Tsumgo/Solar-Landscape-Lights-Control-System/PolarLightSys/学习资料/引脚约束.png

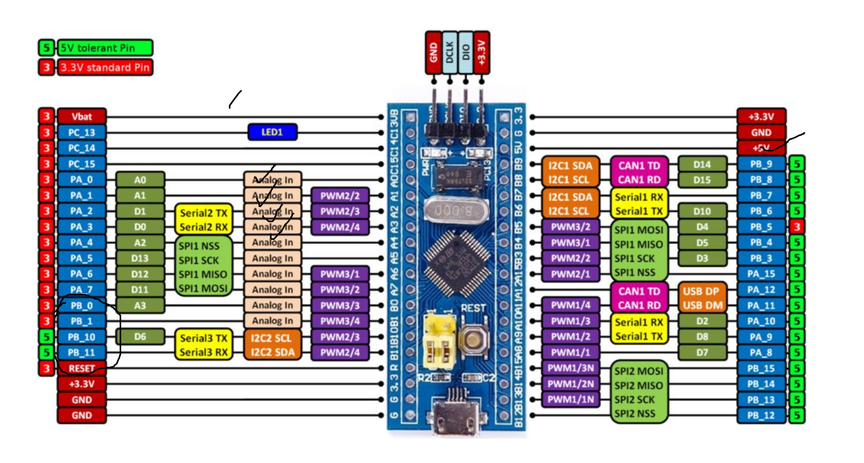
PolarLightSys/学习资料/引脚约束.png
