Tsumgo/Solar-Landscape-Lights-Control-System/PolarLightSys/学习资料/blueTooth/Bluetooth UART Board/c2_jtag2.jpg

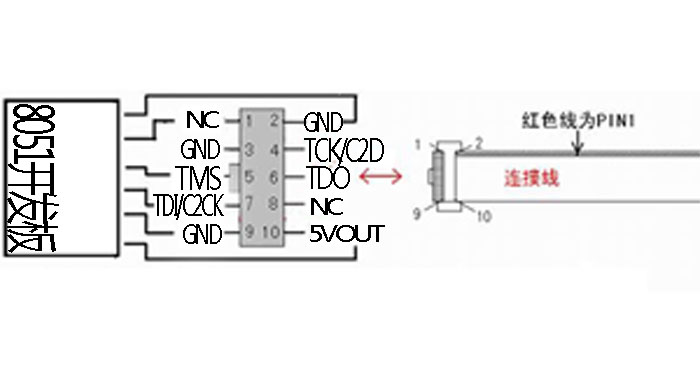
PolarLightSys/学习资料/blueTooth/Bluetooth UART Board/c2_jtag2.jpg
