Tsumgo/Solar-Landscape-Lights-Control-System/PolarLightSys/PCB/G07-太阳能景观灯-BOM.xlsx

No. | Quantity | Comment | Designator | Footprint | Value | Manufacturer Part | Manufacturer | Supplier Part | Supplier
1 | 3 | KF2EDGK-5.08-2P | BAT,LED,SOL | CONN-TH_2P-P5.08_DB2EVC-5.08-2P-BK |  | KF2EDGK-5.08-2P |  | C9900089420 | LCSC
2 | 4 | 10uF | C1,C8,C9,C10 | CAP-TH_BD12.5-P5.00-D0.6-FD | 10uF | EWH2WM220W20OT | AISHI(艾华集团) |  | LCSC
3 | 1 | 22uF | C2 | CAP-TH_BD12.5-P5.00-D0.6-FD | 22uF | EWH2WM220W20OT | AISHI(艾华集团) | C160173 | LCSC
4 | 2 | 470pF | C3,C4 | CAP-TH_L5.3-W3.2-P2.54-D0.6-S2.65 | 470pF | CC1H104ZA1ED3F5O1100 | Dersonic(德尔创) |  | LCSC
5 | 9 | 0.1uF | C5,C6,C7,C11,C12,C13,C14,C15,C16 | CAP-TH_L5.3-W3.2-P2.54-D0.6-S2.65 | 0.1uF | CC1H104ZA1ED3F5O1100 | Dersonic(德尔创) |  | LCSC
6 | 1 | M7 | D1 | SMA_L4.3-W2.6-LS5.2-RD |  | M7 | MDD(辰达半导体) | C95872 | LCSC
7 | 1 | AMS1117-5.0 | LVR | SOT-223_L6.5-W3.5-P2.30-LS7.0-BR |  | AMS1117-5.0 | AMS | C6187 | LCSC
8 | 2 | STP75NF75 | Q1,Q2 | TO-220-3_L10.0-W4.5-P2.54-L |  | STP75NF75 | ST(意法半导体) | C13678 | LCSC
9 | 21 | AXIAL-0.4 | R2,R3,R4,R6,R7,R8,R9,R10,R11,R14,R15,R16,R17,R18,R19,R20,R21,R22,R23,R24,R25 | RES-TH_BD2.7-L8.8-P12.80-D0.5 |  | AXIAL-0.4 |  | C9900024059 | LCSC
10 | 2 | 100mΩ | R5,R13 | R2512 | 100mΩ | CSRN2512FKR500 | SEI(Stackpole Electronics Inc.) |  | LCSC
11 | 1 | 4Ω | R12 | R2512 | 4Ω | CSRN2512FKR500 | SEI(Stackpole Electronics Inc.) |  | LCSC
12 | 2 | 10kΩ | R26,R27 | R2512 | 10kΩ | CSRN2512FKR500 | SEI(Stackpole Electronics Inc.) |  | LCSC
13 | 1 | STM32103C8T6 | STM1 | STM32_C8T6_核心板
14 | 4 | TS665CJ | SW1,SW2,SW3,SW4 | SW-TH_4P-L6.0-W6.0-P4.50-LS6.5 |  | TS665CJ | SHOU HAN(首韩) | C393938 | LCSC
15 | 2 | XH2.54_20P | U2,U3 | XH2.54_20P
16 | 1 | LM358FVT-GE2 | U4 | TSSOP-8_L4.4-W3.0-P0.65-LS6.4-BL |  | LM358FVT-GE2 | ROHM(罗姆) | C4369934 | LCSC
17 | 1 | HS96L03W2C03 | U6 | OLED-TH_L27.8-W27.2-P2.54_C9900033791 |  | HS96L03W2C03 | HS(汉昇) | C5248080 | LCSC
18 | 1 | ICL7660M/TR | U7 | SOP-8_L4.9-W3.9-P1.27-LS6.0-BL |  | ICL7660M/TR | HGSEMI(华冠) | C356724 | LCSC
19 | 2 | 8050 | U8,U9 | TO-92-3_L4.8-W3.7-P2.54-R |  | 8050 | BLUE ROCKET(蓝箭) | C3037602 | LCSC
