Tsumgo/Solar-Landscape-Lights-Control-System/PolarLightSys/学习资料/NANO STM32F1_V2.0_SCH.pdf

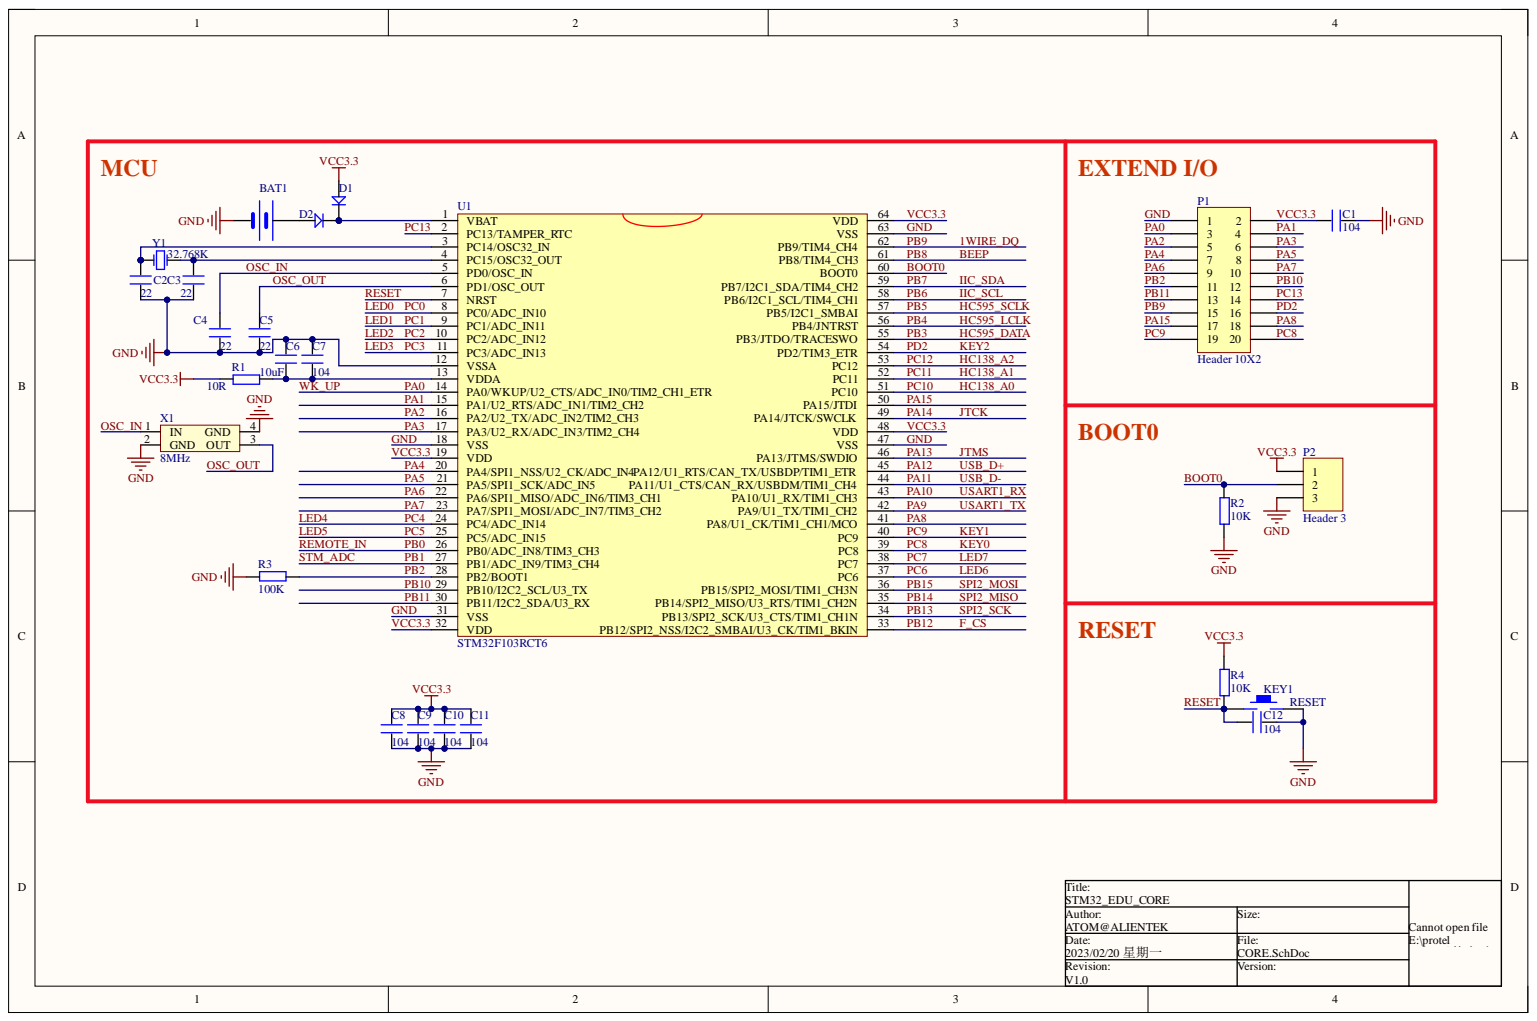
[picture p134: page 1]

T i t l e : STM3 2 _ E D U _ C O RE | Can n o t o pen fi le E : \pro t e l

A u t h o r : AT OM@A LIE N T E K | Size :

Dat e : 0 星期一 2 0 2 3 / 0 2/ 2 | Fi l e : CORE.Sch D o c

Rev i s i o n : V . | Vers i o n :

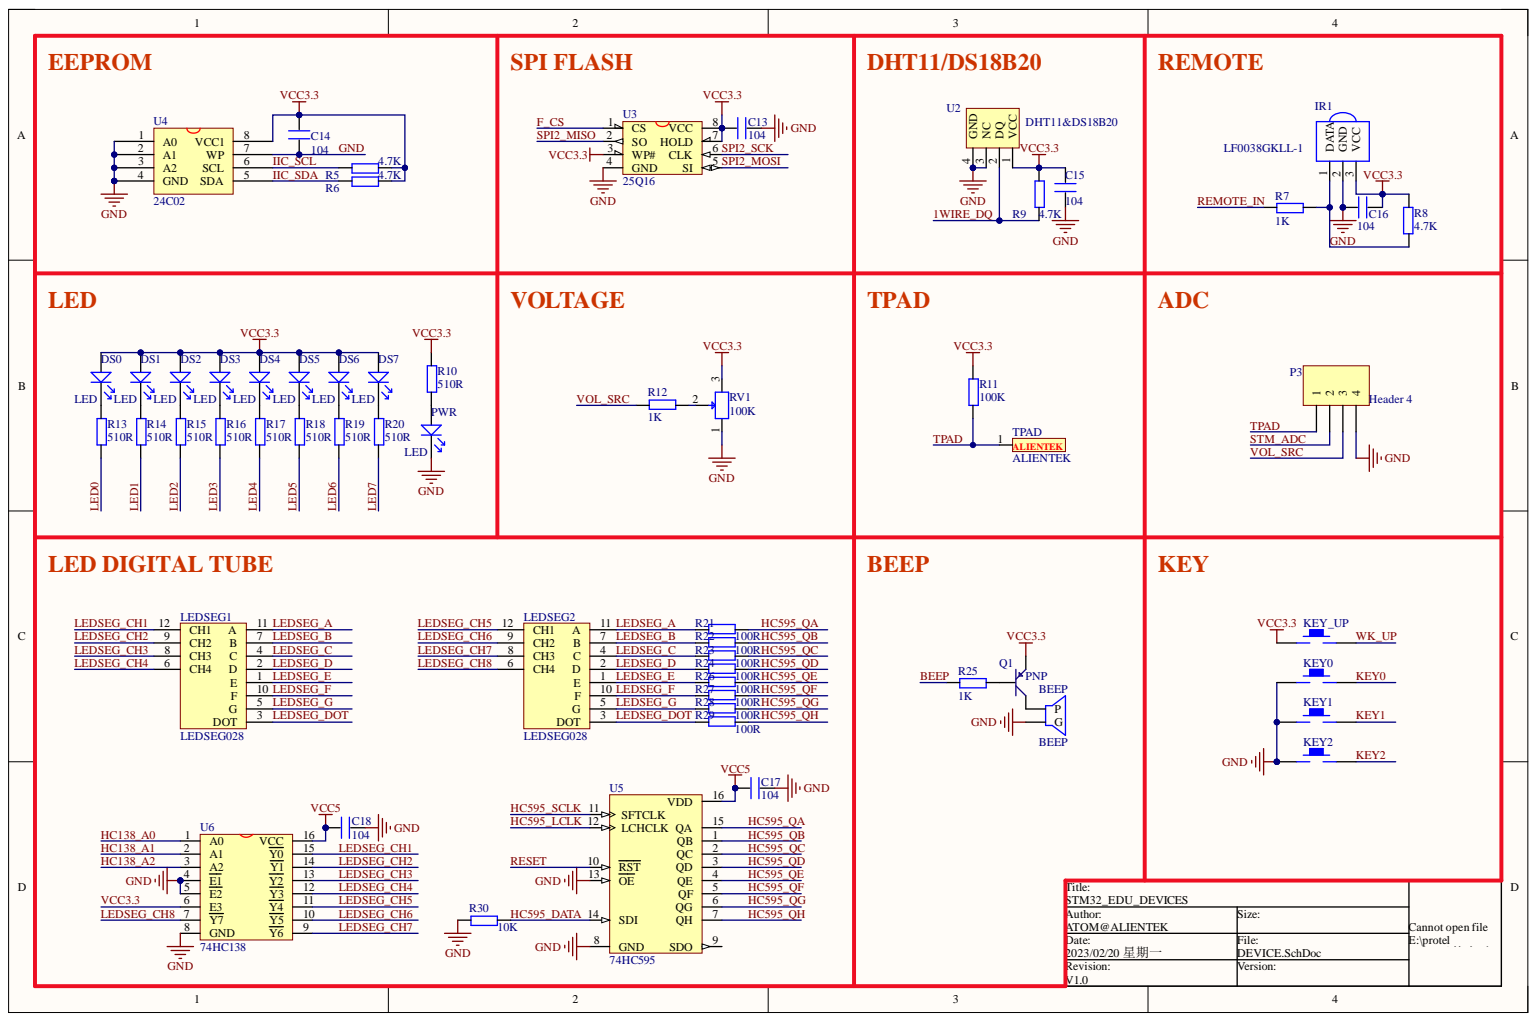
[picture p135: page 2]

VCC 1 DQ 2 NC 3 GND 4

Date: 2023/02/20 星期一 | File: DEVICE.SchDoc

Revision: V1.0 | Version:

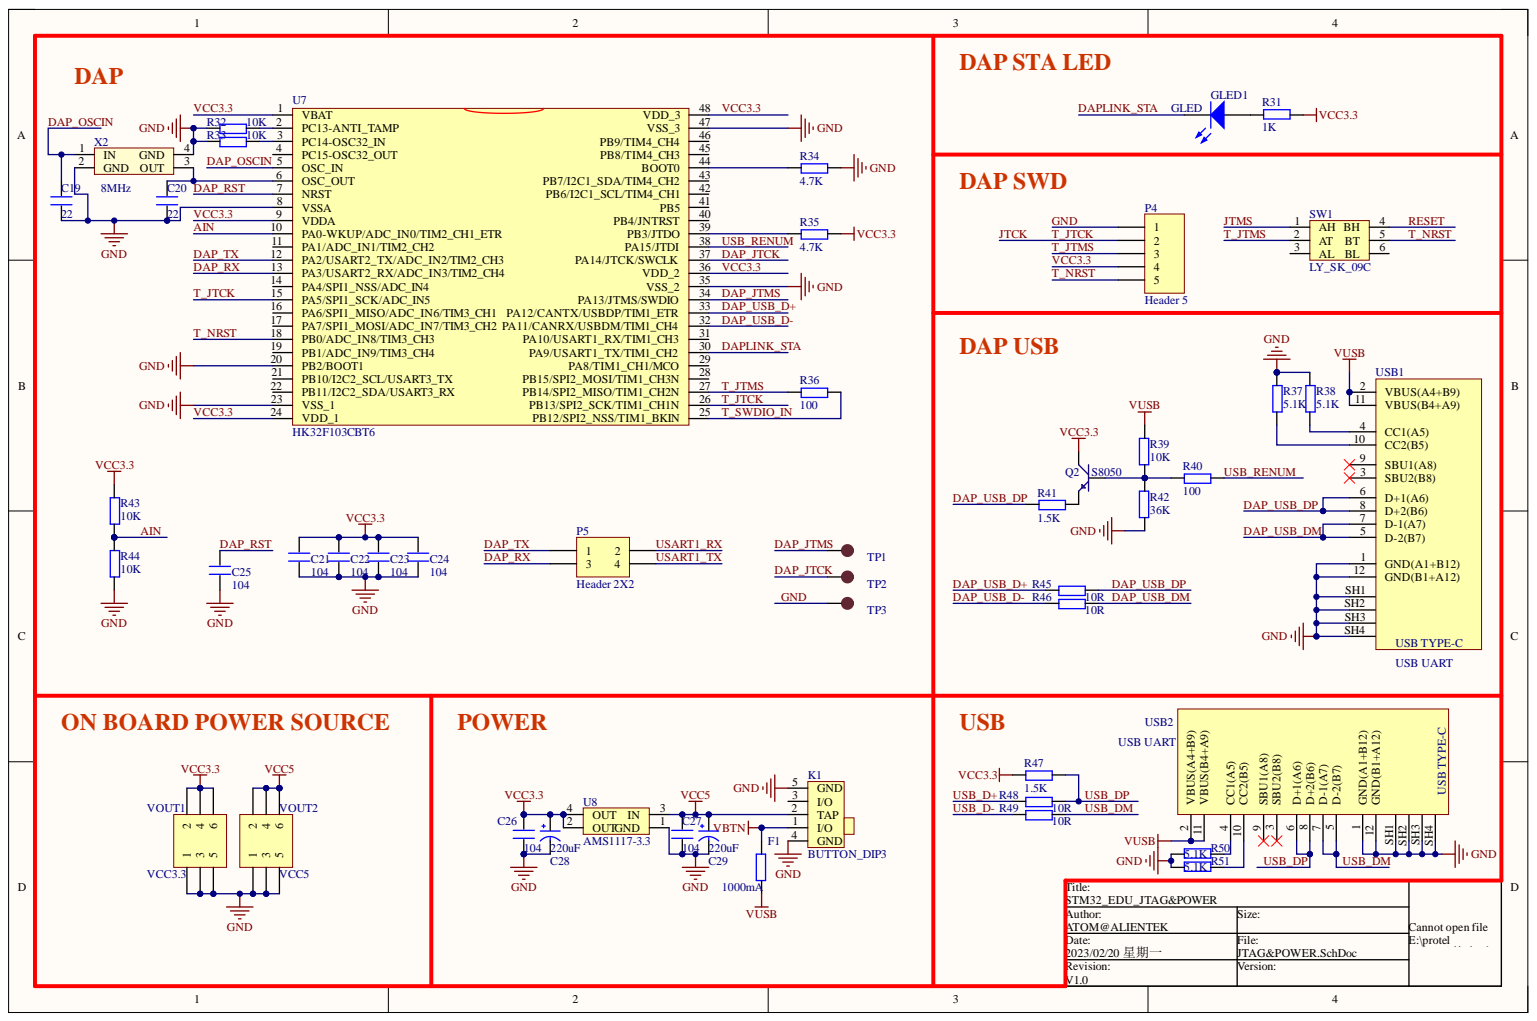
[picture p136: page 3]

DAP U7 | DAP STA LED GLED1

PC13-ANTI_TAMP 2

GND(B1+A12) 12

Shield2 SH2

Shield4 SH4

GND 4

Date: 2023/02/20 星期一 | File: JTAG&POWER.SchDoc

Revision: V1.0 | Version:

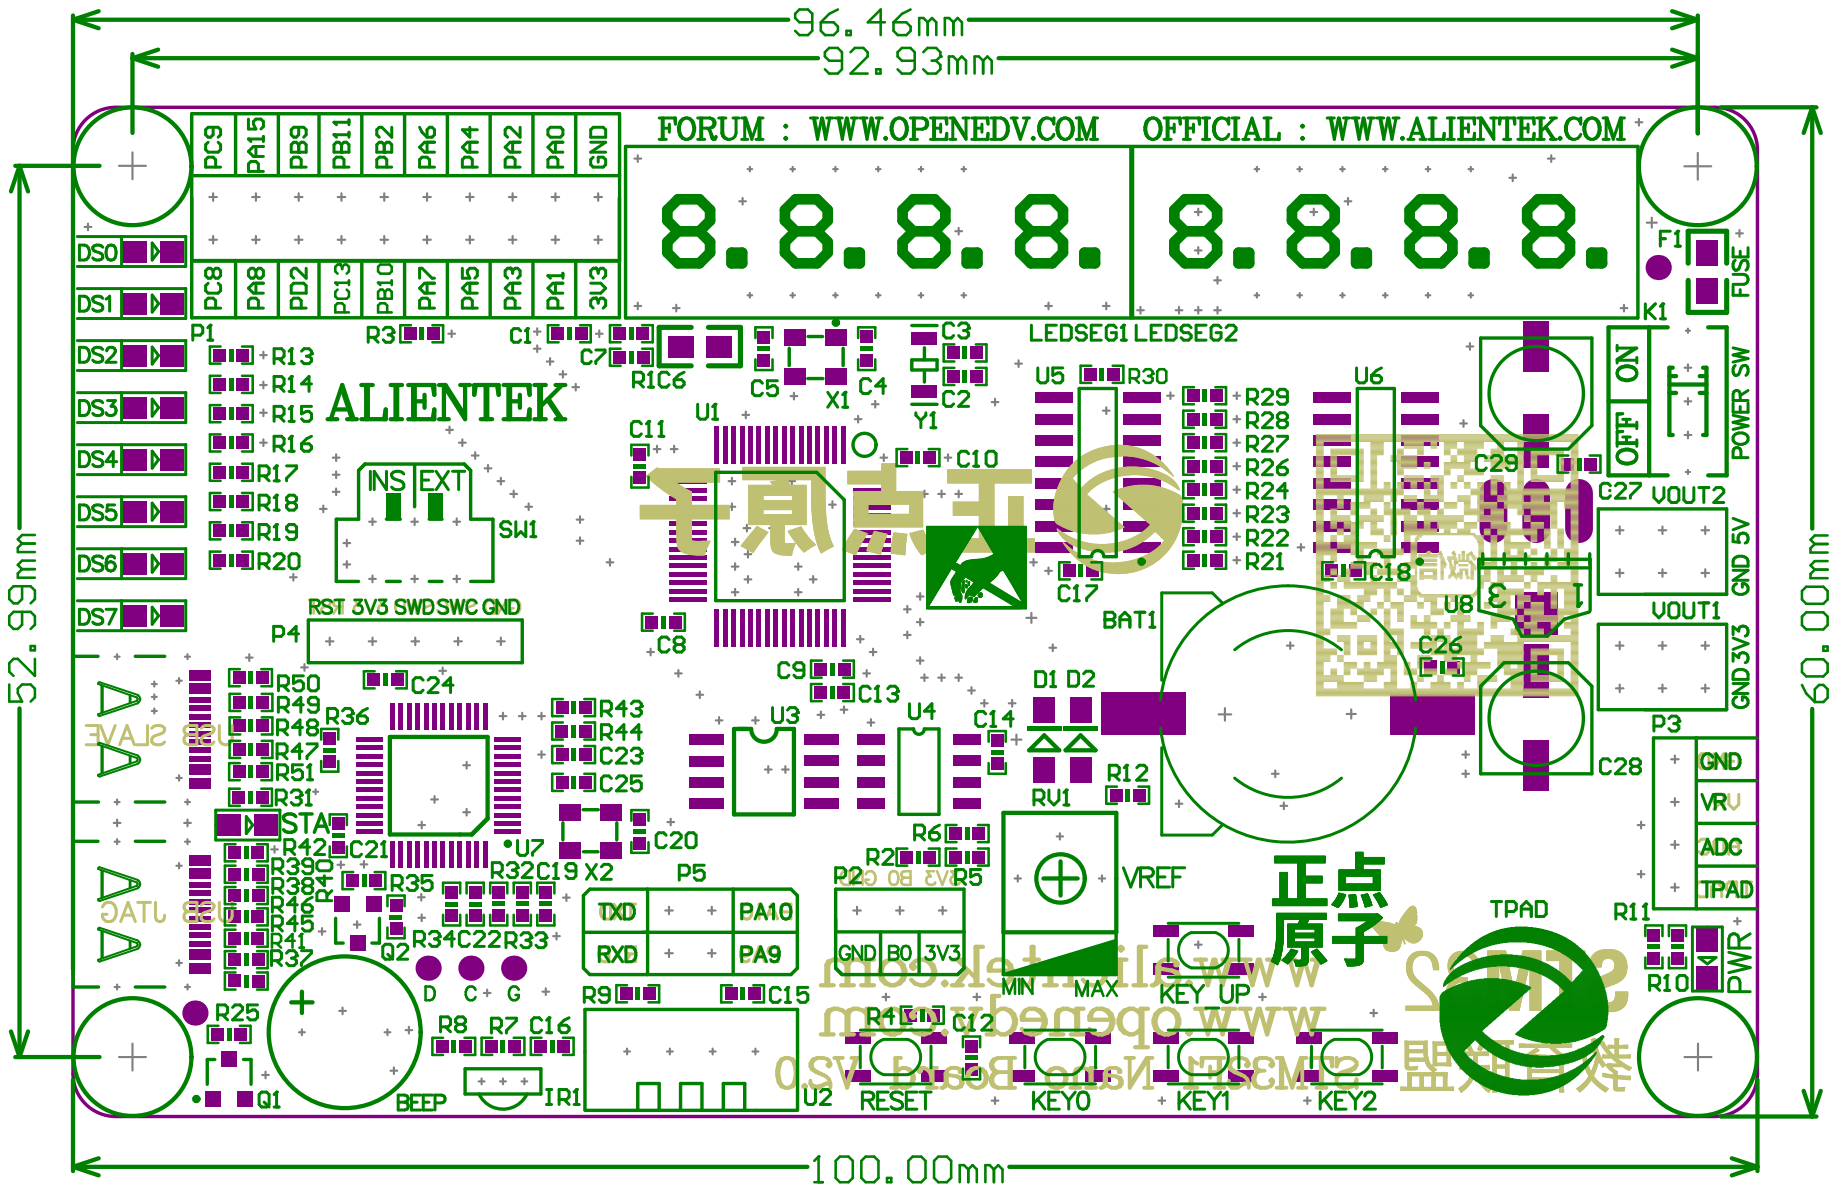
[picture p137: page 4]
