Tsumgo/Solar-Landscape-Lights-Control-System/(list of files, drawings)

Other design files:
PolarLightSys/PCB/G07_太阳能景观灯_PCB终稿_2024-07-05.epro
