Tsumgo/Solar-Landscape-Lights-Control-System/PolarLightSys/Code/User/main.h

#ifndef __MAIN_H
#define __MAIN_H

#define LED_Pin GPIO_PIN_13
#define LED_GPIO_Port GPIOC
#define ADC_VBAT_Pin GPIO_PIN_1
#define ADC_VBAT_GPIO_Port GPIOA
#define ADC_VSL_Pin GPIO_PIN_2
#define ADC_VSL_GPIO_Port GPIOA
#define ADC_ILED_Pin GPIO_PIN_3
#define ADC_ILED_GPIO_Port GPIOA
#define ADC_ICHARGE_Pin GPIO_PIN_4
#define ADC_ICHARGE_GPIO_Port GPIOA
#define S1_Pin GPIO_PIN_0
#define S1_GPIO_Port GPIOB
#define S2_Pin GPIO_PIN_1
#define S2_GPIO_Port GPIOB
#define S3_Pin GPIO_PIN_10
#define S3_GPIO_Port GPIOB
#define S4_Pin GPIO_PIN_11
#define S4_GPIO_Port GPIOB

#define S1        HAL_GPIO_ReadPin(S1_GPIO_Port,S1_Pin)  //S1按键PB0
#define S2        HAL_GPIO_ReadPin(S2_GPIO_Port,S2_Pin)  //S2按键PB1
#define S3        HAL_GPIO_ReadPin(S3_GPIO_Port,S3_Pin)  //S3按键PB10
#define S4        HAL_GPIO_ReadPin(S4_GPIO_Port,S4_Pin)  //S4按键PB11

#define S1_PRES	1	//S1  
#define S2_PRES	2	//S2 
#define S3_PRES	3	//S3
#define S4_PRES	4	//S4 

#define state_stop    		0 //待机模式
#define state_V_charge  	1 //恒压充电模式
#define state_I_charge  	2 //恒流充电模式
#define state_use_charge  3 //供电模式


#define SL_limit    2000   //白天黑夜分界线

#endif /* __MAIN_H */
