Tsumgo/Solar-Landscape-Lights-Control-System/PolarLightSys/学习资料/demo/J_WaterfallLight_1-4/Core/Src/main.c

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
/* Includes ------------------------------------------------------------------*/
#include "main.h"
#include "adc.h"
#include "i2c.h"
#include "tim.h"
#include "usart.h"
#include "gpio.h"
#include "OLED12864.h"
#include "codetab.h"

/* USER CODE BEGIN Includes */
#include <stdio.h>
/* USER CODE END Includes */


void SystemClock_Config(void);
/* USER CODE BEGIN PFP */

uint8_t KEY_Scan(uint8_t mode);
void	Tone(uint16_t DelayV);
void LED_Write_Data(uint8_t duan,uint8_t wei);
void LED_Refresh(void);
uint8_t	Compare_string(char *s);


/* USER CODE END PFP */

/* USER CODE BEGIN 0 */

	uint8_t flag_1=0;			//流水灯定时标志
	uint8_t	flag_KS =0;			//按键扫描标志
	uint8_t	flag_WLRun =0;		//流水灯运行标志
	uint8_t	flag_Forward =0;	//流水灯方向标志
	uint8_t	flag_DSP =0;		//数码管显示处理，每5ms进行
	uint8_t	uartRx_flag =0;		//串口接收标志
	uint8_t	RxTimeOut_flag =0;	//Uart接收超时标志
	uint8_t	ADC_flag=0;			//ADC转换标志
	uint8_t	OLEDFlash_flag=0;	//OLED刷新标志
	
	uint16_t CountTimer =0;
	uint16_t CountTimer10ms =0;
	uint8_t	KeyV =0;			//取得键值
	uint16_t Delayms_V =50;
	uint8_t	LedState =0;
	uint8_t	LedTemp =0;

	uint8_t smg_wei=0;//数码管位选
	uint8_t smg_duan=0;//数码管段选
	uint16_t t=0;
	uint8_t	DSPBuff[8] ={16,16,16,16,16,6,7,8};	//数码管显存
	//共阴数字数组
	//分别是：0,1,2,3,4,5,6,7,8,9,A,B,C,D,E,F,.,全灭；每个num包含8位
	uint8_t smg_num[]={0xfc,0x60,0xda,0xf2,0x66,0xb6,0xbe,0xe0,0xfe,
	0xf6,0xee,0x3e,0x9c,0x7a,0x9e,0x8e,0x02,0x00};
	uint8_t	Time10ms=0,TimeS=0,TimeM=0;		//计时器

	uint16_t pwm_val =0;
	
	uint8_t	TxBuf[16];
	uint8_t RxByte;
	uint8_t	RxBuf[32];
	uint8_t	RxCount =0;
	uint8_t	RxLen =0;
	uint8_t	RxTimeOutCount =5;

	uint16_t	ADCValue;
	
/* USER CODE END 0 */

/**
  * @brief  The application entry point.
  * @retval int
  */
int main(void)
{
  /* USER CODE BEGIN 1 */
//	uint8_t	TxBuf[] ="Usart Test\r\n";
	uint8_t	i;

  /* USER CODE END 1 */

  /* MCU Configuration--------------------------------------------------------*/

  /* Reset of all peripherals, Initializes the Flash interface and the Systick. */
  HAL_Init();

  /* Configure the system clock */
  SystemClock_Config();

  /* Initialize all configured peripherals */ 
  MX_GPIO_Init();
  MX_TIM1_Init();
  MX_TIM2_Init();
  MX_USART1_UART_Init();
  MX_ADC1_Init();
  MX_I2C2_Init();
  /* USER CODE BEGIN 2 */
  HAL_TIM_PWM_Start(&htim2,TIM_CHANNEL_2);
  HAL_TIM_Base_Start_IT(&htim1);
  
  HAL_UART_Receive_IT(&huart1,&RxByte,1);
  
  	OLED_Init();
	OLED_P8x16Char(0,0,'K');
	OLED_P16X32Str(0,0,"Voltag=");
	OLED_P16X32Str(0,4,"  xxxxmV");
//	HAL_Delay(2000);
	OLED_DisplayTurn(0);
//	HAL_Delay(2000);
//	Draw_BMP(30,0,32,32,peiqi32X32);
//	HAL_Delay(2000);	
	OLED_ColorTurn(0);
  
  /* USER CODE END 2 */

  /* Infinite loop */
  /* USER CODE BEGIN WHILE */
  while (1)
  {

	  if(OLEDFlash_flag)
	  {
		OLEDFlash_flag =0;
		  //sprintf(TxBuf,"%02d:%02d:%02d",time[0],time[1],time[2]++);
		OLED_P16X32Str(32,4,(uint8_t *)TxBuf);
		//OLED_P6x8Str(0,7,(uint8_t *)TxBuf);
	  }
//---------------------------------------------------------AD转换处理处理
	  if(ADC_flag)
	{
	  	ADC_flag =0;
		HAL_ADC_Start(&hadc1);							//启动ADC转换
		HAL_ADC_PollForConversion(&hadc1,10);			//等待转换完成
		ADCValue = HAL_ADC_GetValue(&hadc1);			//获取转换值
		//printf("ADC value = %4d\r\n",ADCValue);		//打印输出
		HAL_UART_Transmit(&huart1,(uint8_t *)"ADC value =", 11, 11);
		
		ADCValue =ADCValue*3300/4095;					//AD值转换为电压值
		
		TxBuf[0] =((ADCValue/1000) %10) +0x30;			//串口发送电压值
		TxBuf[1] ='.';
		TxBuf[2] =((ADCValue/100) %10) +0x30;
		TxBuf[3] =((ADCValue/10) %10) +0x30;
		TxBuf[4] =((ADCValue) %10) +0x30;
		HAL_UART_Transmit(&huart1,TxBuf,5, 5);
		HAL_UART_Transmit(&huart1,(uint8_t *)"V\r\n", 3, 3);
		
		DSPBuff[4] =(ADCValue/1000) %10;				//数码管显示电压值
		DSPBuff[5] =(ADCValue/100) %10;
		DSPBuff[6] =(ADCValue/10) %10;
		DSPBuff[7] =ADCValue %10;

	}
	  
	  
//---------------------------------------------------------串口接收处理
	if(uartRx_flag)
	{
	uartRx_flag =0;
		if((Compare_string("AT"))&&(RxLen ==2))					//通信测试
		{
		HAL_UART_Transmit(&huart1,(uint8_t *)"OK\r\n", 4, 4);
		//printf("AT");
		}
		else if(Compare_string("AT+RUN="))						//运行控制
			flag_WLRun =RxBuf[7] -0x30;		

			else if(Compare_string("AT+GAP="))					//参数传递
		Delayms_V =(RxBuf[7] -0x30)*10+(RxBuf[8] -0x30);		
		
		Tone(50);

		for (i = 0; i < 32; ++i)								//清除缓冲区
			{
			RxBuf[i] =0;
			}
	}	
	  
//---------------------------------------------------------流水灯处理
	if (flag_1)
	{
		flag_1 = 0;
		if (flag_WLRun)
			{
			LedState++;
			LedState &= 0x07;			//限定状态范围
			if (flag_Forward)
				{
				LedTemp =1;
				LedTemp =LedTemp << LedState;	//依据状态确定点灯的位置
				}
			else
				{
				LedTemp =0x80;
				LedTemp =LedTemp >> LedState;
				}
			HAL_GPIO_WritePin(GPIOC,0xff,GPIO_PIN_SET);			//清除灯	
			HAL_GPIO_WritePin(GPIOC,LedTemp,GPIO_PIN_RESET);	//点灯
			}
	}
	  
	//---------------------------------------------------------按键处理
	if (flag_KS)
		{
		__HAL_TIM_SET_COMPARE(&htim2,TIM_CHANNEL_2,500 +pwm_val);
			
		//HAL_UART_Transmit(&huart1,(uint8_t *)"Hello world!\r\n", 14, 14);	//查询方式发送
		//HAL_UART_Transmit(&huart1,TxBuf,12, 10);
			
		//HAL_UART_Transmit_IT(&huart1,(uint8_t *)"Hello world!\r\n", 14);
		//HAL_Delay(5);
		//HAL_UART_Transmit_IT(&huart1,TxBuf,12);
			

		KeyV = KEY_Scan(0);				//按键扫描
		 switch (KeyV)
        {
            case KEY0_PRES://KEY0
            Tone(50);
			flag_Forward ++;
			flag_Forward &=0x01;
			pwm_val =0;
				break;

            case KEY1_PRES://KEY1
            Tone(50);
			if (Delayms_V < 200)
				{
				Delayms_V +=5;
				}
				
			if (pwm_val >=100)		//减小PWM脉宽
				{
				pwm_val -=100;
				}
                break;

            case WKUP_PRES://控制BEEP
            Tone(50);
			if (Delayms_V > 5)
				{
				Delayms_V -=5;
				}

			if (pwm_val <=1900)		//增大PWM脉宽
				{
				pwm_val +=100;
				}
            break;

            case KEY2_PRES://KEY_UP
            Tone(50);
			flag_WLRun ++;
			flag_WLRun &=0x01;
			pwm_val =2000;
                break;

            default:
				break;

        }
	
		}


	//---------------------------------------------------------显示处理
	if (flag_DSP)
		{
		flag_DSP =0;

		smg_wei++;
		smg_wei &=0x07;
		//if(smg_wei==8) smg_wei=0;

		smg_duan =DSPBuff[smg_wei];
		LED_Write_Data(smg_num[smg_duan],smg_wei);//数码管显示
		LED_Refresh();//刷新显示

		if (smg_wei ==7)
			{
/*			DSPBuff[0] =TimeM /10;
			DSPBuff[1] =TimeM %10;
			
			DSPBuff[3] =TimeS /10;
			DSPBuff[4] =TimeS %10;

			DSPBuff[6] =Time10ms /10;
			DSPBuff[7] =Time10ms %10;
*/

/*			DSPBuff[7] =((pwm_val+500)/100) %10;
			DSPBuff[6] =((pwm_val+500)/1000) %10;
			DSPBuff[5] =((pwm_val+500)/10000) %10;
*/
			}
		}
	
    /* USER CODE END WHILE */

    /* USER CODE BEGIN 3 */
  }
  
  
  
  
  
  
  /* USER CODE END 3 */
}

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
/* USER CODE BEGIN 4 */


int fputc(int ch, FILE *f)
{
  HAL_UART_Transmit(&huart1, (uint8_t *)&ch,1,10);
  return ch;
}



uint8_t	Compare_string(char *s)
{
	uint8_t	i=0;
//	Equ_flag =1;
	while (*s)
	{
		if (RxBuf[i++] != *s++)
		{
			//Equ_flag =0;
			return 0;
		}	
	}
	return 1;
}	



//---------------------------------------------------------中断处理程序
void HAL_UART_RxCpltCallback(UART_HandleTypeDef *huart)
{
	if(huart ==&huart1)
	{
		//uartRx_flag =1;
		RxBuf[RxCount] =RxByte;
		RxCount++;
		RxTimeOutCount =5;
/*
		if (RxTimeOut_flag)
			{
			RxLen =RxCount;
			}
*/		
		HAL_UART_Receive_IT(&huart1,&RxByte,1);
	}
}



//-----------------------------------------------------------单音信号
void	Tone(uint16_t DelayV)
{
	HAL_GPIO_WritePin(BELL_GPIO_Port,BELL_Pin,GPIO_PIN_RESET);	
	HAL_Delay(DelayV);
	HAL_GPIO_WritePin(BELL_GPIO_Port,BELL_Pin,GPIO_PIN_SET);
}


//-----------------------------------------------------------TIM1中断回调函数
void HAL_TIM_PeriodElapsedCallback(TIM_HandleTypeDef *htim)
{
	if(htim->Instance ==TIM1)
	{
		
	if (RxTimeOutCount !=0)			//判断Rx超时？
	{
		RxTimeOutCount --;
		if (RxTimeOutCount ==0)
			{
			uartRx_flag =1;
			RxLen =RxCount;
			RxCount =0;
			}	
	
	}
		
//	  flag_1 = 1;
	CountTimer ++;
	CountTimer10ms ++;
	
	  if(CountTimer > Delayms_V)	//"Delayms_V",置流水灯刷新标志
	  {
	  	flag_1 = 1;
		CountTimer = 0;  
	  }

	  if (CountTimer10ms >9)		//10ms，置按键扫描标志
		  {
		  CountTimer10ms =0;
		  flag_KS =1;
			
			if(flag_Forward) 
				{
				Time10ms --;
				if (Time10ms ==50)
					{
					ADC_flag=1;				//ADC标志
					//DSPBuff[2] =17;		//显示“   ”
					//DSPBuff[5] =17;
					}

				if (Time10ms ==255)
					{
					Time10ms =99;

						
					//DSPBuff[2] =16;		//显示“-”
					//DSPBuff[5] =16;

					TimeS --;			//秒表计时
					OLEDFlash_flag =1;	//OLED每秒刷新一次
					
					if (TimeS ==255)
						{
						TimeS =59;
						TimeM --;			//秒表计时
						if (TimeM ==255)
							{
							TimeM =59;
							}
						}
					}
				}			//秒表计时
			else 
				{
				Time10ms ++;
				if (Time10ms ==50)
					{
					ADC_flag=1;				//ADC标志
					//DSPBuff[2] =17; 	//显示“   ”
					//DSPBuff[5] =17;
					}
				
				if (Time10ms >99)
					{
					Time10ms =0;
				
					//DSPBuff[2] =16; 	//显示“-”
					//DSPBuff[5] =16;
				
					TimeS ++;			//秒表计时
					OLEDFlash_flag =1;	//OLED每秒刷新一次					
					if (TimeS >59)
						{
						TimeS =0;
				
						TimeM ++;			//秒表计时
						if (TimeM >59)
							{
							TimeM =0;
							}
						}

					}
				}
	  }

	if (CountTimer10ms & 0x01)	//2ms，置数码显示处理标志
		{
		flag_DSP =1;
		}

	}

}	


//-----------------------------------------------------------按键处理函数
//返回按键值
//mode：0,不支持连续按;1,支持连续按;
//返回值：//0，没有任何按键按下//KEY0_PRES，KEY0按下//KEY1_PRES，KEY1按下//KEY2_PRES，KEY2按下//WKUP_PRES，WK_UP按下 
//注意此函数有响应优先级,KEY0>KEY1>KEY2>WK_UP!!
uint8_t KEY_Scan(uint8_t mode)
{
	static uint8_t key_up=1;//按键按松开标志
	if(mode)key_up=1;  //支持连按		  
	
	if (key_up)
	{					//有按键按下？
		if(KEY0 ==0)
		{
			key_up=0;
			return KEY0_PRES;
		}
		else if(KEY1 ==0)
		{
			key_up=0;
			return KEY1_PRES;
		}
		else if(KEY2 ==0)
		{
			key_up=0;
			return KEY2_PRES;
		}
		else if(WK_UP ==1)
		{
			key_up=0;
			return WKUP_PRES;
		}
	}
	else if(KEY0==1 && KEY1==1 && KEY2==1 && WK_UP==0) key_up=1;	//检查是否所有按键弹起？
		return 0;

}

//-----------------------------------------------------------数码管显示处理函数
void HAL_Delay_us(uint16_t us)
{
	uint16_t	Temp;

	if (us--)
		{
			for (Temp = 0; Temp < 72; ++Temp)
			{
			}
		}
}

//74HC138 驱动
//数码管位选
//num:要显示的数码管编号 0-7(共 8 个数码管)
void LED_Wei(uint8_t num)
{
 	HAL_GPIO_WritePin(LED_A0_GPIO_Port,LED_A0_Pin,(GPIO_PinState)(num&0x01));
	HAL_GPIO_WritePin(LED_A1_GPIO_Port,LED_A1_Pin,(GPIO_PinState)((num&0x02)>>1));
	HAL_GPIO_WritePin(LED_A2_GPIO_Port,LED_A2_Pin,(GPIO_PinState)((num&0x04)>>2));
}


//74HC595 驱动
//数码管显示
//duan:显示的段码
//wei:要显示的数码管编号 0-7(共 8 个数码管)
void LED_Write_Data(uint8_t duan,uint8_t wei)
{
uint8_t i;
for( i=0;i<8;i++)//先送段
{
	HAL_GPIO_WritePin(LED_DS_GPIO_Port,LED_DS_Pin,(GPIO_PinState)((duan>>i)&0x01));
	HAL_GPIO_WritePin(LED_SCK_GPIO_Port,LED_SCK_Pin,GPIO_PIN_RESET);
	HAL_Delay_us(5);
	HAL_GPIO_WritePin(LED_SCK_GPIO_Port,LED_SCK_Pin,GPIO_PIN_SET);
}
 LED_Wei(wei);//后选中位
}


//74HC595 驱动
//数码管刷新显示
void LED_Refresh(void)
{
	HAL_GPIO_WritePin(LED_LCLK_GPIO_Port,LED_LCLK_Pin,GPIO_PIN_SET);
	HAL_Delay_us(5);
	HAL_GPIO_WritePin(LED_LCLK_GPIO_Port,LED_LCLK_Pin,GPIO_PIN_RESET);
}








/* USER CODE END 4 */
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
