Tsumgo/Solar-Landscape-Lights-Control-System/(notices)

Notices in the files:
PolarLightSys/学习资料/demo/J_WaterfallLight_1-4/Core/Src/main.c:
Copyright (c) 2023 STMicroelectronics.
All rights reserved.
This software is licensed under terms that can be found in the LICENSE file
